KoaSchuette/HandoverCapstone/README.md

# Collaborative Robotic Tool Handover System

Welcome! This is the capstone project of MREN 403 Group 16 at Queen's University (Smith Engineering).

We built a collaborative robot assistant for a manufacturing work cell. Working beside an operator at a workbench, a UR5e arm takes a spoken request for a screwdriver, picks it off a tool rack with an electromagnetic end effector, and hands it to the operator. When the operator puts a tool down in the return zone, the robot picks it up and returns it to the rack.

This repository holds the ROS 2 workspace (`src/`) and the engineering portfolio that documents it.

## Where to go

| I want to… | Go to |
|---|---|
| Understand the project: requirements, design, decisions, testing, and how to run each subsystem | [Engineering portfolio](Engineering_Portfolio/README.md) (start with the [system overview](Engineering_Portfolio/system/README.md)) |
| Set up a computer to run it (Linux) | [docs/setup_linux.md](docs/setup_linux.md) |
| Set up a computer to run it (Windows) | Not written yet |
| Find a launch or build command quickly | [docs/common_commands.md](docs/common_commands.md) ([plain-text copy](docs/common_commands.txt)) |
