KoaSchuette/HandoverCapstone/Engineering_Portfolio/tool-rack/02_decisions/adjustable-arms.md

# Adjustable arms, starting at 35 cm

## Decision

Leave the two frame arms that connect the pegboard uprights to the cart uncut and longer than needed, and clamp the uprights along them so the board can slide toward or away from the robot. Start at 35 cm, the fastest position in the distance study, about 5.5 cm closer than the CAD position (40.5 cm arms). Once the camera has been shown to detect the screwdrivers reliably from the observation pose, cut the arms to the chosen length.

## Why the distance matters

Board distance changes how far the base has to turn between picking up a tool and the staging pose, where the robot holds the tool and waits for the operator's hand before the handover move. In the [pegboard distance study](../06_experiments/pegboard-distance/), the pickup → handover move at 0.3 speed scaling took:

| Board offset from CAD (m) | −0.07 | −0.05 | 0 (CAD) | +0.05 | +0.10 | +0.15 | +0.20 |
|---|---|---|---|---|---|---|---|
| Pickup → handover (s) | 2.81 | **3.14** | 3.47 | 3.64 | 3.74 | 3.82 | 3.87 |

Moving 5 cm closer saved 0.34 s (about 10%), the largest gain of any step. Going 2 cm further was still faster, but the arm is folded almost back on itself as seen in [Pickup at −0.07 m](../06_experiments/pegboard-distance/pickup_-0.07.png).

## Options considered

| Option | For | Against |
|---|---|---|
| Fixed at the CAD position (40.5 cm) | Matches the existing CAD and sim; most reach margin | 10% slower handover; no way to tune after testing |
| Fixed at 35 cm | Fastest position found | About 2 cm from the reach limit, and that limit comes from a study with known gaps (see below) |
| **Adjustable, starting at 35 cm** (chosen) | Starts at the fastest position, and can back off if reach or camera view is a problem | Sliding joints can shift, so the position has to be checked after any move |

## Why adjustable

Two things can't be settled in the sim:

1. **Real reach margin.** The study moved the board in the collision model, but the sim arm had no gripper or camera on the wrist. Build tolerances on the frame and brackets add more uncertainty.
2. **Camera view.** The eye-in-hand camera has a fixed focus: soft closer than about 0.2 m, sharp from 0.25 m. If the board is too close, the observation pose may not be able to back off far enough to keep the tools in focus and in frame.

Either one could force the board back out. Making the arms adjustable costs nothing extra, because the 30 mm extrusion already allows sliding and the extrusions haven't been cut yet.

## How to adjust it

1. Loosen the bracket bolts on both arms and slide the board to the new position. Keep both arms the same length so the board stays square.
2. Re-tighten, then repeat the datum check (see [Fixed position](fixed-position.md)).
3. Update the `pegboard_face` frame in `handover_cell` to the new position, so the robot's targets match the board.

## How it will be verified

- **Sim:** run the pickup at −0.055 m on the team's full robot model (`workcell.urdf.xacro`, which has the gripper on the wrist) to check the clearance of the folded arm.
- **Real robot:** time pickup → staging at 35 cm and at the CAD position. The real robot uses the team's MoveIt config (`handover_moveit_config`, max joint acceleration 2.0 rad/s²), not UR's config (5 rad/s²) used in the study. By the same timing model, each move should take about 0.9 s longer than in the sim at 0.3 scaling. The gap between the two positions should stay about 0.4 s, because it depends only on how far the base turns. Pass: 35 cm is faster by about that much.
- **Camera:** confirm all three screwdrivers are detected from the observation pose at 35 cm.

Once all three pass, cut the arms to that length.

## Looking back

The sim arm had no end effector, so the tightest positions were checked on an arm slimmer than the real one. The study was strong enough to set a direction (closer is faster, and the hard limit is at −0.075 m) but not a final dimension. Keeping the arms adjustable is the response to that: the length is only cut once the real robot and the camera confirm it. Starting again, we'd define the pickup relative to the board and let MoveIt solve the angles, and run the sweep on the full model with the gripper attached.
