KoaSchuette/HandoverCapstone/notes.txt

note for lab computer to run "getent group render" to find group number

how to make ros node 

Python package with a starter node

ros2 pkg create handover_voice --build-type ament_python --dependencies rclpy std_msgs --node-name command_listener
                 example name                lang    

Custom messages/services package
ros2 pkg create handover_interfaces --build-type ament_cmake

how to colcon build
cd /workspaces/HandoverCapstone
colcon build --packages-select handover_hand_tracking
source install/setup.bash
ros2 run handover_hand_tracking leap_node

How ot run ultra leap node with rviz
ros2 launch handover_hand_tracking hand_tracking.launch.py

How to run Ultra leap software no C library
run this in termial(linux only)
ultraleap-hand-tracking-control-panel

how to run real sense launch file(camera node)
ros2 launch handover_realsense realsense.launch.py

how to run skeleton tracking node with rviz 
ros2 launch handover_skeleton_tracking skeleton.launch.py

ultraleap output

hand
├── type, id, confidence
├── grab_strength, pinch_strength
├── palm
│   ├── position      (x, y, z in mm)
│   ├── orientation   (quaternion)
│   ├── normal, direction, velocity, width
├── arm
│   ├── prev_joint    (elbow position)
│   ├── next_joint    (wrist position)
│   ├── rotation    (quaternion)
│   └── widith    
└── digits[5]         (thumb, index, middle, ring, pinky)
    └── bones[4]      (metacarpal, proximal, intermediate, distal)
        ├── prev_joint   (x, y, z where the bone starts)
        ├── next_joint   (x, y, z where the bone ends)
        ├── rotation     (quaternion)
        └── width

YOLO26 pose keypoints (COCO order, 17 per person)
Each keypoint: x, y (pixels) + confidence (0 to 1)
Left/right = the PERSON's left/right, not the camera's

0  nose
1  left eye
2  right eye
3  left ear
4  right ear
5  left shoulder
6  right shoulder
7  left elbow
8  right elbow
9  left wrist
10 right wrist
11 left hip
12 right hip
13 left knee
14 right knee
15 left ankle
16 right ankle

Arm joints for motion prediction: 5 to 10
