KoaSchuette/HandoverCapstone/Engineering_Portfolio/system/imgs/ros_node_architecture_v1.png

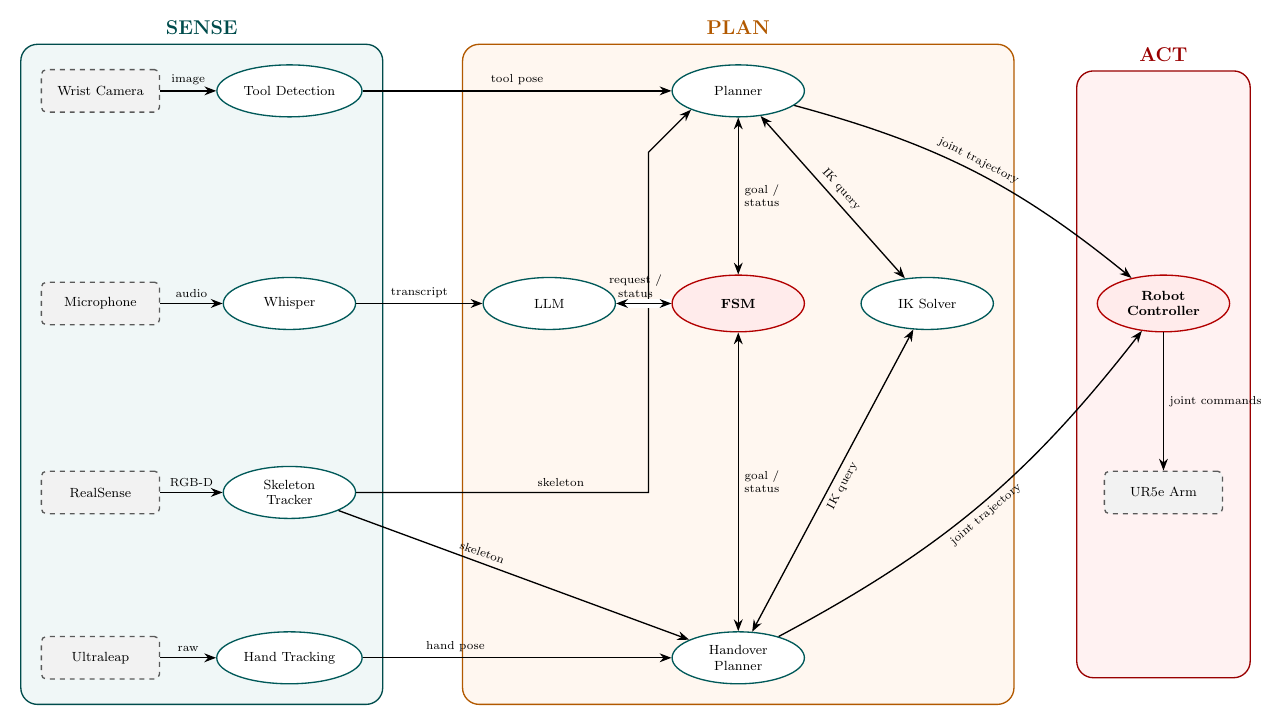
Engineering_Portfolio/system/imgs/ros_node_architecture_v1.png
