KoaSchuette/HandoverCapstone/Engineering_Portfolio/tool-rack/04_design/BOM.md

# Tool rack bill of materials

Snapshot of the rack parts from the team's Parts Ordering sheet (Running BOM), as of Nov 11, 2026. Prices in CAD, before tax.

## Frame and board

| # | Part | Part number | Supplier | Qty | Unit | Total | Funded by | Status |
|---|---|---|---|---|---|---|---|---|
| 11 | Aluminium extrusion, 30 mm, 10 ft | [5537T97](https://www.mcmaster.com/5537T97/) | McMaster-Carr | 2 | $74.57 | $149.14 | Team | Received |
| 12 | Perforated hardboard panel, 3/16" × 2' × 4', cut to 400 × 300 mm| SKU 1000432702 | Home Depot | 1 | $13.77 | $13.77 | Team | Received |
| 13 | Feet / stoppers | [5537T983](https://www.mcmaster.com/5537T983/) | McMaster-Carr | 2 | $10.67 | $21.34 | Team | Received |
| 14 | 30 mm M6 self-aligning nut, 4-pack | [6000N207](https://www.mcmaster.com/6000N207/) | McMaster-Carr | 7 | $7.68 | $53.76 | Team | Partly received |
| 15 | 45 mm M6 self-aligning nut, 4-pack | [5278N32](https://www.mcmaster.com/5278N32/) | McMaster-Carr | 1 | — | — | Ingenuity Labs | Received |
| 16 | M6 × 14 mm screw | [91290A665](https://www.mcmaster.com/91290A665/) | McMaster-Carr | 1 | — | — | Ingenuity Labs | Received |
| 17 | 40 mm M6 self-aligning nut, 4-pack | [6000N204](https://www.mcmaster.com/6000N204/) | McMaster-Carr | 7 | $8.23 | $57.61 | Team | Not Received |
| 18 | Screwdriver hooks | — | 3D printed | 3 | — | — | Personal | Not printed |
| 19 | Angle brackets, 30 mm to 45 mm extrusion | — | 3D printed | 12 | — | — | Personal | Not printed |

## Tools

| # | Part | Supplier | Qty | Unit | Total | Funded by | Status |
|---|---|---|---|---|---|---|---|
| 21 | Screwdriver | Mastercraft | 3 | $7.49 | $22.47 | Team | Purchased |

## Totals (team budget)

| | Amount |
|---|---|
| Frame and board | $295.62 |
| Tools | $22.47 |
| **Rack total** | **$318.09** |

3D-printed parts are printed on personal printers at no cost to the project budget.

Numbers match the team Parts Ordering sheet. If the two ever disagree, the sheet is the source of truth.
