KoaSchuette/HandoverCapstone/Engineering_Portfolio/tool-rack/04_design/Capstone Assembly Actual.step

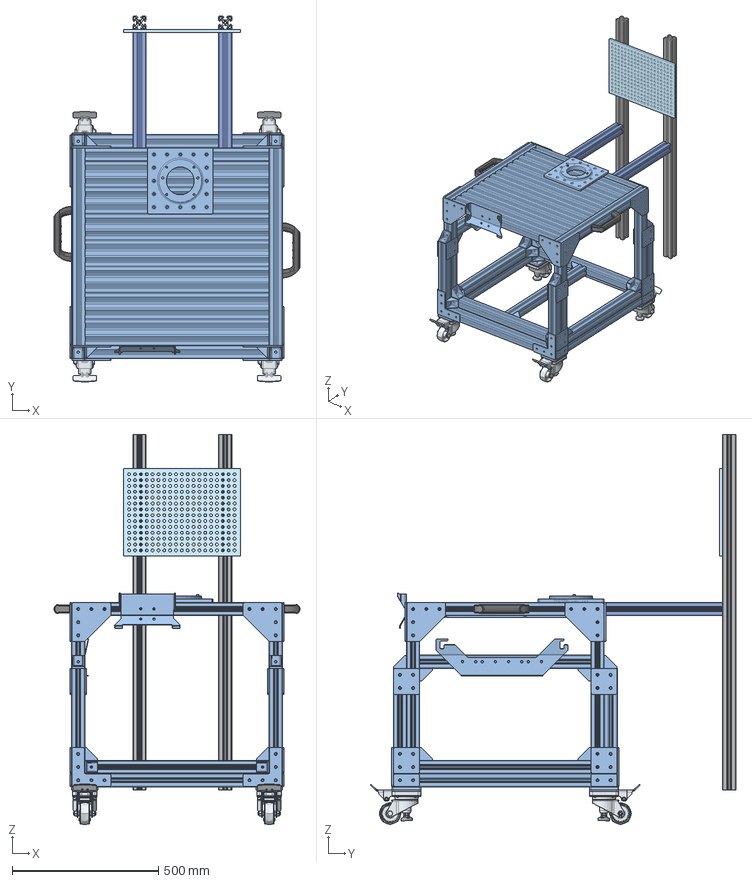
[picture p10: CAD file, 2026-11-10]
Engineering_Portfolio/tool-rack/04_design/Capstone Assembly Actual.step
839.9 x 1249.1 x 1332.5 mm
ST-EXT-001-0630 x 5
ST-EXT-002-0630 x 7
ST-EXT-001-0540 x 4
ST-EXT-001-0675 x 4
ST-EXT-001-0585 x 4
ST-GP-001-0019 x 2
ST-GP-001-0009 x 8
ST-HP-003-0001 x 24
ST-RB-001-0003
ST-EXT-001-0405 x 4
ST-GP-001-0003 x 14
HW-HD-001-0001__2-0 x 2
HW-HD-001-0001__2-1 x 4
ST-SP-010-0001 x 4
MO-WL-003-0001 x 4
ST-GP-001-0005 x 4
ST-GP-001-0016 x 4
ST-GP-003-0001 x 4
ST-RB-002-0001__2
ST-RB-002-0003-0 x 2
ST-RB-002-0003-1 x 2
ST-RB-002-0003-2
ST-GP-001-0014 x 2
Capstone
