KoaSchuette/HandoverCapstone/Engineering_Portfolio/end-effector/04_design/cad/wire_relief_clamp_camera.step

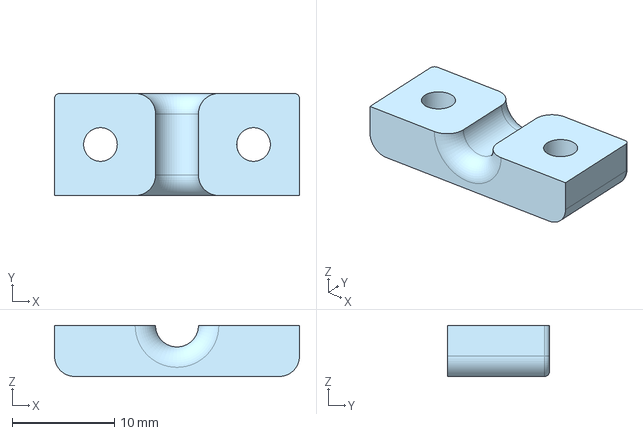
[picture p11: CAD file, 2026-11-13]
Engineering_Portfolio/end-effector/04_design/cad/wire_relief_clamp_camera.step
24.0 x 10.0 x 5.00 mm
