KoaSchuette/HandoverCapstone/src/handover_cell/meshes/collision/pegboard.stl

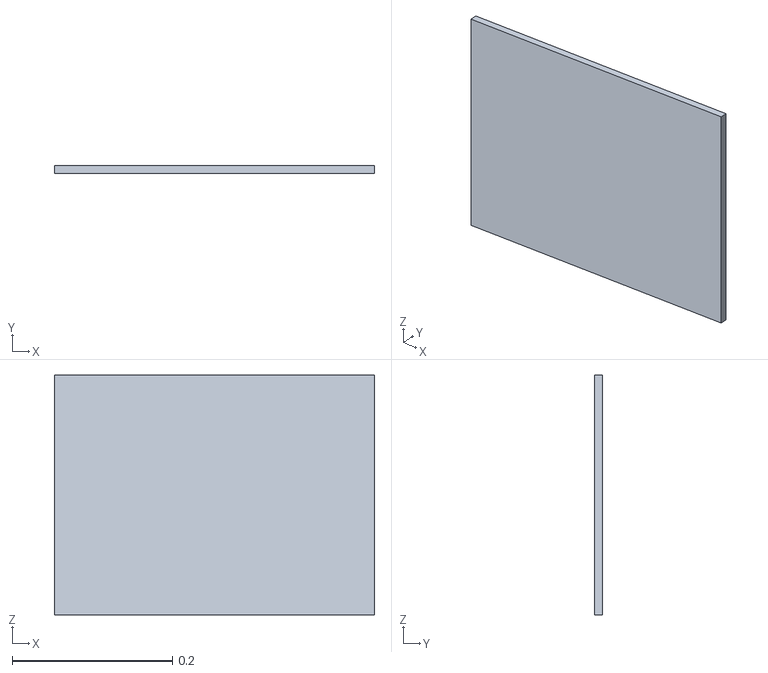
[picture p12: CAD file, 2026-11-08]
src/handover_cell/meshes/collision/pegboard.stl
0.4 x 0.01 x 0.3
