KoaSchuette/HandoverCapstone/Engineering_Portfolio/end-effector/04_design/cad/master_bracket.step

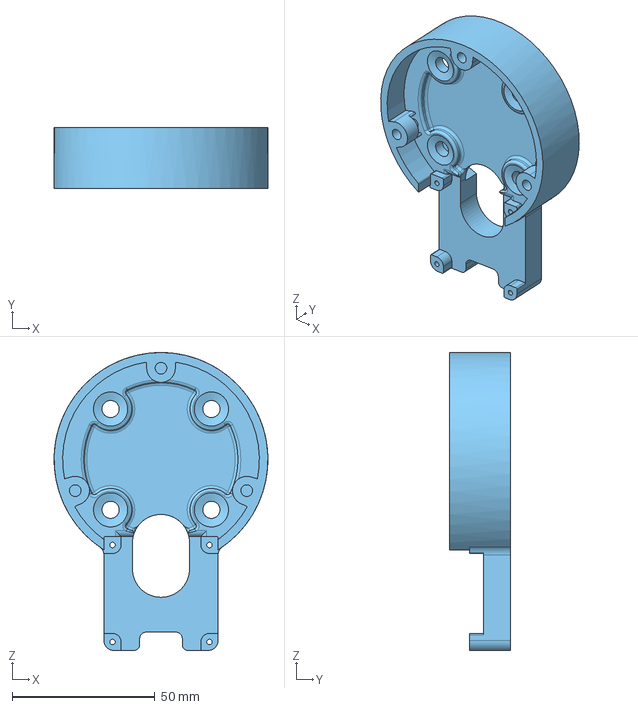
[picture p13: CAD file, 2026-11-13]
Engineering_Portfolio/end-effector/04_design/cad/master_bracket.step
75.0 x 21.5 x 104.5 mm
