KoaSchuette/HandoverCapstone/src/handover_cell/meshes/collision/cart.stl

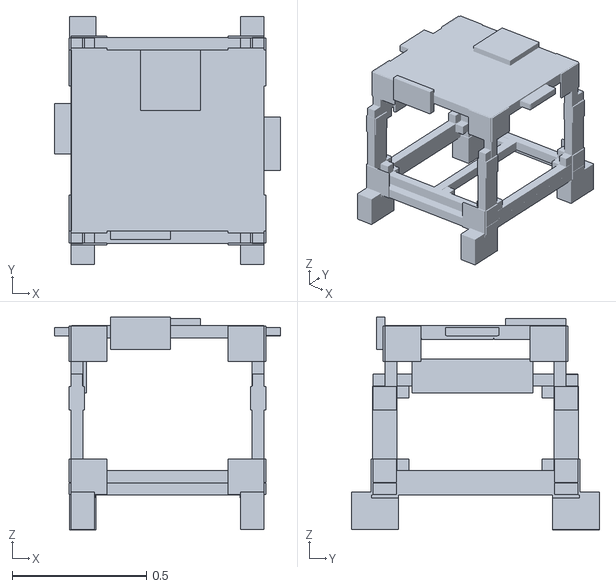
[picture p14: CAD file, 2026-11-08]
src/handover_cell/meshes/collision/cart.stl
0.841 x 0.925 x 0.792
