KoaSchuette/HandoverCapstone/Engineering_Portfolio/tool-pickup/06_experiments/intrinsic-calibration/chessboard_10x7_20mm_letter.pdf

10 x 7 squares, 20.00 mm | OpenCV pattern size (9, 6) | Print at 100% / actual size | 5 squares should measure 100 mm
100 mm check
