KoaSchuette/HandoverCapstone/(commit log)

2026-10-21 Added handover_cell that has base, peg board, and ur5e
2026-10-23 Remove colons from URDF comments (they break the YAML parse of robot_description)
2026-10-26 Added WIP handover_demo. Sens a Pilz PTP joint goal and gives the planned move time
2026-11-08 Add ELP camera capture script (starter)
2026-11-08 Intrinsic calibration of ELP eye-in-hand camera complteded
2026-11-09 Added Assembly CAD
2026-11-11 Add decision document for adjustable arms design
    Documented the decision to use adjustable arms starting at 35 cm for the tool rack, including reasons for the distance, options considered, adjustment instructions, and verification methods.
2026-11-11 Add decision document for pegboard tool rack
    Documented the decision to use a hardboard pegboard with 3D-printed hooks for tool storage, including context, options considered, and verification methods.
2026-11-11 Add decision document for fixed board positions
    Document the decision to use fixed positions for the board without fiducial markers, including context, options considered, and the rationale behind the chosen approach.
2026-11-11 Add decision document for frame and brackets design
    Documented the decision to use 30 mm aluminium extrusion for the pegboard frame and brackets, including options considered and their implications.
2026-11-11 Update CAD render and improve README clarity
    Updated the CAD render image and modified the figure description in the README. Removed a TODO comment and adjusted the contents table for clarity.
2026-11-11 Fix image path for tool rack CAD figure
    Updated image path for tool rack CAD figure in README.
2026-11-11 Create BOM for tool rack design
    Added a bill of materials (BOM) for the tool rack, detailing parts, suppliers, quantities, and costs.
2026-11-11 uploaded files for expirement
    cycle_times.csv is the data from the simulation expirement, time_vs_offset.png is the output of plot_times.py, which shows the plot of the time the sim took vs the offset of the board
2026-11-11 Fix CSV path to reference current directory
2026-11-12 Tool rack: add -0.07/+0.20 results, long-arm wording, 3/16" board, design README
2026-11-12 Created README and camera.md, describing the subsystem the camera decision choice
2026-11-12 Tool pickup: add camera decision and intrinsic calibration experiment
2026-11-12 Add end-effector README and built-circuit photos
2026-11-12 Add end-effector magnet feasibility calculation and driver circuit design page
    - 03_calculations: magnet feasibility for a 1/4 inch steel shaft (vertical and
    horizontal lift)
    - 04_design: driver circuit page with updated KiCad schematic (1N5819),
    simulation with and without the flyback diode, built-circuit photos and
    wire table
    - README: add end effector photo, update folder table and open issues
2026-11-12 Add end-effector decision records and relink README
    - Add 02_decisions/electromagnet.md (decision analysis vs suction and
    parallel jaw) and 02_decisions/power-architecture.md (controller I/O,
    XL4016 buck converter, low-side MOSFET).
    - Move simulation PNGs to 09_figures and update driver-circuit.md links.
    - Drop force-sensed release from end-effector scope in the README
    (R2, status, next steps) and link the decision records in the folder
    table.
    - Remove empty 03_calculations/force_sensor placeholder.
2026-11-12 Add end-effector mechanical design page, CAD and figures
    - Add 04_design/mechanical-design.md: parts, fasteners, master bracket
    iterations, test build, wire relief clamp bend, and a file table.
    - Add STEP files for the brackets, wire relief clamps, dress clamps and
    clips, and supply isolation mount under 04_design/cad/.
    - Add the Onshape assembly render and photos to 09_figures/ and move the
    built-circuit photos there.
    - Replace the README overview photo, link the design page, and update
    the open issue and next step for the wire relief clamps.
2026-11-13 Update tool-pickup status from 'Model Training' to 'Calibration done'
